isakbolin99/Discgolfcounting/images/schematic.png

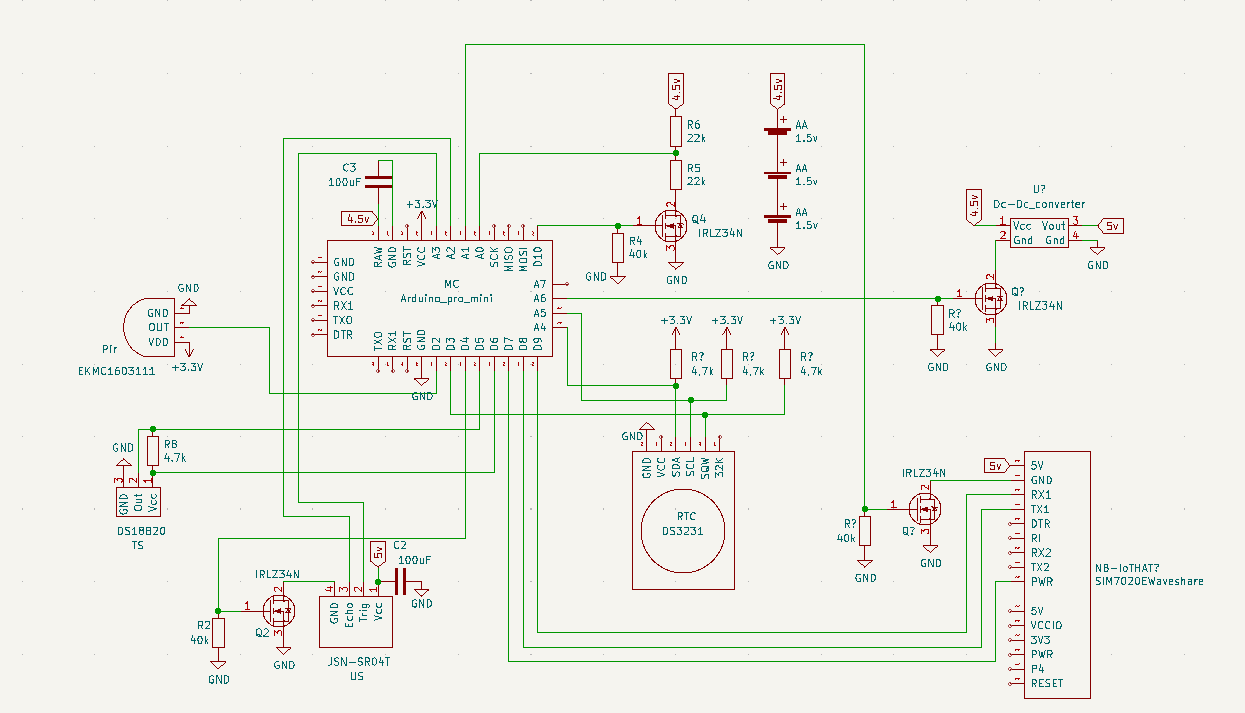
images/schematic.png
